gwbae0904/Capstone_V3/Assets/SteamVR/InteractionSystem/Samples/Grenade/SunFlare.png

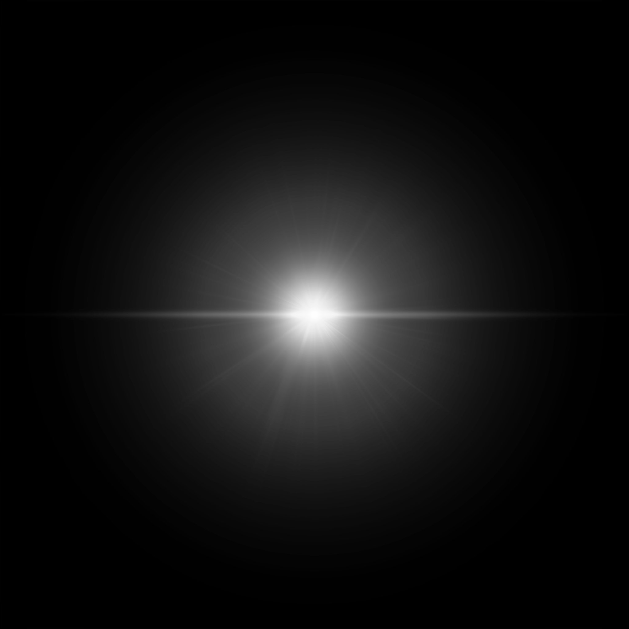
Assets/SteamVR/InteractionSystem/Samples/Grenade/SunFlare.png
