gwbae0904/Capstone_V3/(commit log)

2026-07-12 초기 세팅: Unity VR 프로젝트
2026-07-16 HandVisual, Interactions_Example 씬 업데이트 및 README/.gitignore 정리
2026-07-17 Hand/HandVisual 스크립트 및 예제 씬 업데이트, gitignore에 크래시 복구 파일 제외 추가
2026-08-05 Lucas glove 방식 햅틱 피드백 로직 및 hover 경합 버그 수정
    물체별 손가락 정지값(GraspPoseTrigger)을 hover/grab 상태에 따라
    아두이노로 자동 전송하도록 SerialGloveReceiver에 로직 추가. 물체가
    겹쳐 있을 때 hover 경합으로 grab이 안 풀리던 문제를 Hand.cs에서
    가장 가까운 물체 하나만 hover하도록 고쳐서 해결. iVCam 자동 탐색
    추가, README를 최신 동작에 맞게 갱신.
2026-08-12 햅틱 정지값 각도 기반으로 변경, 물체별 Grab Threshold/깊이 반전 옵션 추가
    GraspPoseTrigger의 손가락별 정지값을 0~1000 추상값 대신 실제 서보 각도(0~180도)
    기준으로 입력하도록 변경(시리얼 프로토콜은 그대로, Unity 쪽에서만 역산 변환).
    Hand.cs가 물체별 Custom Grab Threshold를 지원하도록 확장. ArucoHandTracker에
    카메라-손 거리와 화면상 깊이 관계를 반전시키는 Invert Depth 옵션 추가.
    GraspPoseTrigger.cs를 Assets/Scripts와 Assets/SteamVR 양쪽 어셈블리에 동일하게
    배치(Hand.cs가 참조하기 위해 필요). README에 위 내용 반영.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
2026-09-02 README 심사/시연용으로 전면 개편, 개발 기록 docs/로 분리, ESP32 펌웨어 리팩터
    - README: 개발 배경/핵심 기술/시연 이미지 중심으로 재구성, 상세 트러블슈팅은 docs/DEVELOPMENT_LOG.md로 이동
    - GloveFirmware.ino를 GloveFirmware/ 폴더로 이동하며 손가락 캘리브레이션(부팅 시 자동 3초)과 서보 반전 로직을 정리
2026-09-08 손등 마커 다중 인식 안정화, 햅틱 프로토콜 각도 직접 전송으로 변경
    - ArucoHandTracker: 손등 마커 3개 동시 인식 시 히스테리시스(markerSwitchThresholdRatio)로
    잦은 전환 억제, 마커별 positionOffset을 현재 회전만큼 돌려 적용해 전환 시 위치 튐 완화.
    마커 회전 기반 IMU 드리프트 자동 보정은 튜닝 난이도 대비 실익이 낮아 제거하고 순수 IMU로 복귀
    - GraspPoseTrigger/SerialGloveReceiver: 아두이노 펌웨어가 0~180도 각도를 직접 받는 방식으로
    바뀜에 따라 0~1000 wire 값 변환 로직 제거 (GraspPoseTrigger는 SteamVR 쪽 사본도 동기화)
    - Interactions_Example 씬: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
2026-09-15 손-물체 물리 콜라이더 통합, 웹캠 자동 선택/디버그 토글 개선, 빌드/배포 문서화
    - Hand/HandCollider에 손가락 관절 물리 콜라이더 연동 추가 (LateUpdate에서 매
    프레임 위치 전달, grab 시 충돌 감지 on/off)로 손이 물체를 통과하지 않고
    실제로 밀어내도록 개선
    - ArucoHandTracker에 Preferred Camera Name 옵션 추가, Play 시 연결된 카메라
    목록을 콘솔에 출력해 웹캠 다중 연결 환경에서 원하는 카메라 지정 가능
    - FingerCurlAnimator/SerialGloveReceiver에 Show Debug Info 토글 추가 (시연/
    빌드 전 화면 디버그 텍스트 끄기 용도)
    - PrimitiveSizeSetter, QuitOnKeyPres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
2026-09-22 손 물리 콜라이더 되돌리고 햅틱 시리얼 떨림 수정, 물체 리셋 단축키 추가
    관절 콜라이더 이름이 장갑 모델 뼈 이름과 겹쳐 FindDeepChild가 엉뚱한
    Transform을 찾는 문제로, 손-물체 물리 충돌 기능(HandColliderRight)을
    되돌림. SerialGloveReceiver는 값이 안 바뀌었을 때도 매 프레임 같은
    햅틱 명령을 반복 전송하던 걸 값 변경 시에만 보내도록 수정해 서보
    떨림을 해결. Backspace로 씬의 Throwable 물체를 초기 위치로 리셋하는
    ResetObjectsOnKeyPress 추가. README/DEVELOPMENT_LOG를 위 내용에 맞게
    갱신하고, demo_grab 이미지 확장자 재발 오류(.jpg → .png)도 수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
2026-10-02 ZIG SIM 휴대폰 리모컨 시점 조작 추가, Animator Any State 잔재 전환 버그 수정
    [GloveFirmware.ino]
2026-10-02 README 데모 이미지 확장자 오타 수정 (demo_grab.jpg -> .png)
